BarBaar44/Custom-DBE/hardware/README.md

# v3 hardware files

To be added once the v3 PCB is finished:

* EasyEDA Pro project (`.epro2`)
* Gerber zip for JLCPCB
* BOM and pick and place export
* PCB render (`.png`)

v2 files: [BarBaar44/EasyEDA](https://github.com/BarBaar44/EasyEDA).
