BarBaar44/Custom-DBE/(commit log)

2026-11-02 Initial DBE v3 docs: README, v3 spec, v2 as built, pipe holder, parked DBH
    [ds18b20_tie_holder.scad]
2026-11-02 Move v2 design files into hardware/v2, add MIT license
    v2 EasyEDA project, Gerbers and render copied from BarBaar44/EasyEDA.
    Docs now link to the local files. v3 placeholder moved to hardware/v3.
    Claude-Session: https://claude.ai/code/session_017BEvUoFFGsh9rmxWVFhLKj
2026-11-02 v2 barrel jack: fitted part is 5 A, only the project BOM links a 0.5 A part
    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
2026-11-02 README: offer boards on request
    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
2026-11-02 v3: mark as development board on the silk; README notes boards are dev boards
    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
2026-11-02 v3: dev board marking on top silk
    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
2026-11-02 README: v3 enclosure planned
    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
